ZeniteSolar/MSM21/hardware/rj45.step

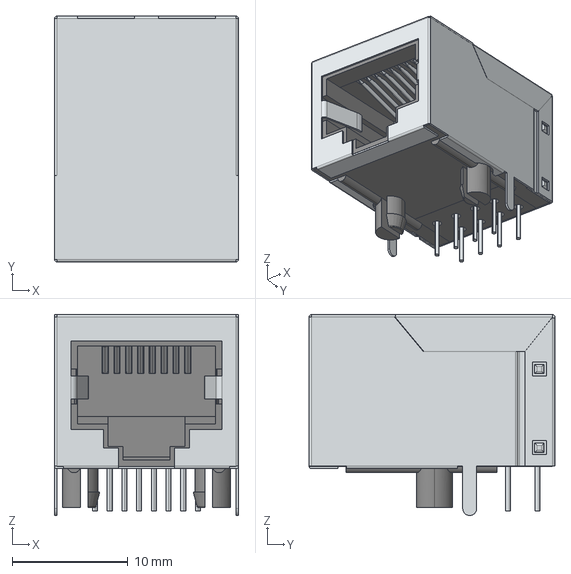
[picture p1: CAD file, 2021-09-09]
hardware/rj45.step
15.9 x 21.2 x 17.3 mm
