ZeniteSolar/MSM21/hardware/PDF/MSM21.pdf

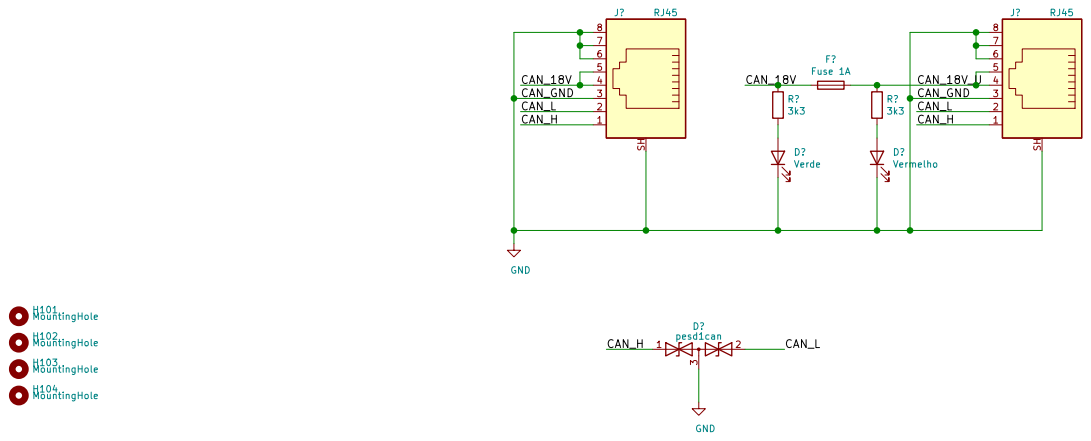
[picture p2: page 1]

Id: 1/1 Title: File: MSM21.sch Sheet: / H103 MountingHole
