ZeniteSolar/MSM21/hardware/MSM21.kicad_pcb

## KiCad design hardware/MSM21.kicad_pcb (2021-09-09)

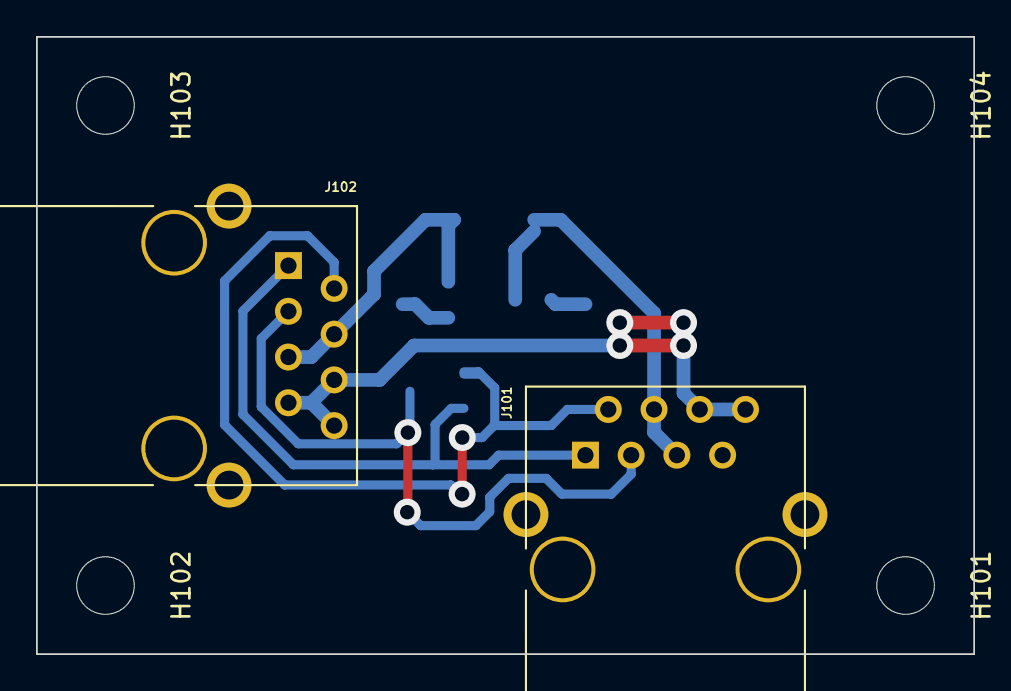
[picture p3: board MSM21.kicad_pcb from above]

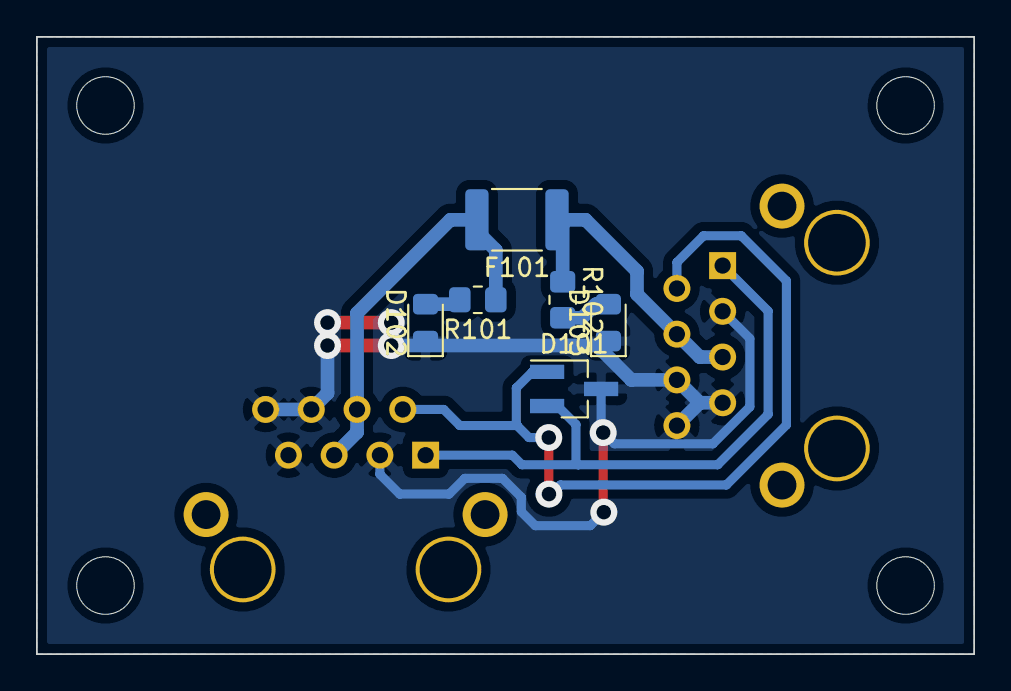
[picture p4: board MSM21.kicad_pcb from below]

Board: 2 copper layers, 52.1 x 34.3 mm, 12 parts (6 on the bottom side), 7 nets.

Parts:
D101: pesd1can; SOT-23_Handsoldering
D102: Verde; LED_0805_2012Metric_Pad1.15x1.40mm_HandSolder
D103: Vermelho; LED_0805_2012Metric_Pad1.15x1.40mm_HandSolder
F101: Fuse 1A; Fuse_1812_4532Metric_Pad1.30x3.40mm_HandSolder
H101, H102, H103, H104: MountingHole; MountingHole_3.2mm_M3
J101, J102: RJ45; RJ45_YH59_01
R101, R102: 3k3; R_0805_2012Metric_Pad1.20x1.40mm_HandSolder

Connections:
/CAN_18V: F101.2, J101.4, J101.5, R101.1
/CAN_18V_U: F101.1, J102.4, J102.5, R102.1
/CAN_H: D101.2, J101.1, J102.1
/CAN_L: D101.1, J101.2, J102.2
GND: D101.3, D102.1, D103.1, J101.3, J101.6, J101.7, J101.8, J102.3, J102.6, J102.7, J102.8
unnamed: D102.2, R101.2
unnamed: D103.2, R102.2
